2026-2-NCC6/Projeto1/README.md

# Swing Sense
Grupo 1 - 6º CCOMP
# FECAP - Fundação de Comércio Álvares Penteado
<p align="center">
<a href= "https://www.fecap.br/">FECAP - Fundação de Comércio Álvares Penteado</a>
</p>

# 👨‍💻 Integrantes:<a href="https://github.com/AntonioPetri">Antônio Petri de Moraes Soares de Moura e Oliveira</a>,<a href="https://github.com/paschoalha">Gabriel Higobassi Paschoal</a>, <a href="https://github.com/LucasSilvaMaciel">Lucas Silva Maciel</a>, <a href="https://github.com/ThiagoAkira0">Thiago Akira Higa Mitami</a>
# 👨‍🏫 Professores Orientadores: <a href="https://br.linkedin.com/in/edsonbarbero">Prof. Edson Ricardo Barbero,</a> <a href="https://www.linkedin.com/in/katia-bossi/">Prof. Katia Milani Lara Bossi,</a> <a href="https://www.linkedin.com/in/trencher/">Prof. João Francisco Trencher Martins,<a/> <a href="https://www.linkedin.com/in/professorrodnil/">Prof. Rodnil da Silva Moreira Lisboa <a/> e </a> <a href="https://www.linkedin.com/in/victorbarq/">Prof. Victor Bruno Alexander Rosetti de Quiroz </a>

# 📄 Descrição

O **Swing Sense** é uma raquete de tênis inteligente que capta os movimentos do jogador durante o jogo e identifica automaticamente o tipo de tacada executada — **saque, forehand ou backhand**. Um sensor de movimento (IMU) acoplado ao cabo da raquete, controlado por um microcontrolador ESP32, lê continuamente os dados de aceleração e rotação e os processa por meio de uma máquina de estados capaz de reconhecer o padrão de cada golpe.

Os dados são transmitidos via **Bluetooth (BLE)** para um aplicativo mobile, que exibe estatísticas de desempenho e histórico de treino ao jogador, sem que a raquete precise se conectar diretamente à internet.

O projeto integra, de forma prática, os conteúdos de cinco disciplinas do 6º semestre de Ciência da Computação:

- **Sistemas Embarcados e Robótica** — leitura de sensores e controle do microcontrolador;
- **Projeto Interdisciplinar (IoT)** — arquitetura do ecossistema raquete → app → backend;
- **Teoria da Computação e Linguagens Formais** — formalização da detecção de tacada como uma máquina de estados finitos;
- **Redes de Computadores e Cibersegurança** — comunicação segura entre dispositivo, aplicativo e servidor;
- **Inovação e Empreendedorismo** — estruturação da proposta como oportunidade de negócio.

# 📋 Detalhes
 🗂️ Estrutura de pastas<br>
 ├── 🗂️ Documentos/<br>
 │   ├── 📁 Entrega 1<br>
 │   │   └── 📂 Inovação e Empreendedorismo<br>
 │   │   └── 📂 Projeto Interdisciplinar: Internet das Coisas e Robótica<br>
 │   │   └── 📂 Teoria da Computação e Linguagens Formais<br>
 │   │   └── 📂 Redes de Computadores e Cibersegurança<br>
 │   │   └── 📂 Sistemas Embarcados e Robótica<br>
 │   ├── 📁 Entrega 2<br>
 │   │   └── 📂 Inovação e Empreendedorismo<br>
 │   │   └── 📂 Projeto Interdisciplinar: Internet das Coisas e Robótica<br>
 │   │   └── 📂 Teoria da Computação e Linguagens Formais<br>
 │   │   └── 📂 Redes de Computadores e Cibersegurança<br>
 │   │   └── 📂 Sistemas Embarcados e Robótica<br>
 │   ├── 📄 Banner_FECAP_CCOMP6_AGLT.pdf<br>
 │   ├── 📄 Banner_FECAP_CCOMP6_AGLT.pptx<br>
 │   └── 📄 Documento - Projeto de Extensão - COM Empresa<br>
 ├── 🗂️ Imagens/<br>
 ├── 🗂️ SRC/<br>
 ├── 📄 .gitignore<br>
 └── 📄 readme.md<br>
 
 # 💻 Tecnologias para Desenvolvimento

<ul>
  <li> <a href="https://code.visualstudio.com/">Visual Studio Code</a></li>
  <li> <a href="https://www.arduino.cc/">Arduino (ESP32)</a></li>
  <li> <a href="https://en.cppreference.com/">C/C++</a></li>
  <li> <a href="https://flutter.dev/">Flutter</a></li>
  <li> <a href="https://dart.dev/">Dart</a></li>
  <li> <a href="https://www.python.org/">Python</a></li>
  <li> <a href="https://fastapi.tiangolo.com/">FastAPI</a></li>
  <li> <a href="https://www.postgresql.org/">PostgreSQL</a></li>
  <li> <a href="https://github.com/">GitHub</a></li>
</ul>

# 📋 Licença/License
<a href="https://github.com/2026-2-NCC6/Projeto1">Swing Sense</a> © 2026 by <a href="https://github.com/2026-2-NCC6/Projeto1">Antônio Petri, Gabriel Paschoal, Lucas Maciel, Thiago Akira</a> is licensed under <a href="https://creativecommons.org/licenses/by/4.0/">CC BY 4.0</a>
