2026-2-NCC6/Projeto1/Documentos/Documento - Projeto de Extensao - COM EMPRESA.docx

DOCUMENTO DE PROJETO DE EXTENSÃO

1. DADOS GERAIS

Título do Projeto

Swing Sense: Sensor Embarcado Acoplável para Monitoramento de Desempenho.

Integrantes da equipe

Identificar o nome completo e o RA dos participantes do projeto

Nome: | RA:
Antônio Petri de Moraes Soares de Moura e Oliveira | 24026144
Gabriel Higobassi Paschoal | 21010656
Lucas Silva Maciel | 24025942
Thiago Akira Higa Mitami | 24026254

Professor responsável

Edson Ricardo Barbero, Katia Milani Lara Bossi, João Francisco Trencher Martins, Rodnil da Silva Moreira Lisboa e Victor Bruno Alexander Rosetti de Quiroz.

Curso

Ciência da Computação – 6° Semestre / 2026

Linha de atuação

Identificar com ✓ uma ou mais linhas de atuação conforme projeto pedagógico de curso.

- Projeto Interdisciplinar: | ✓

Tipo de projeto

Identificar com ✓ o tipo de projeto.

- Atividade de Extensão não implementado na prática (proposta de intervenção)
- Atividade de Extensão implementado na prática (intervenção executada) ✓

Tema gerador

ODS 3 – Saúde e Bem-Estar. Promoção da prática esportiva orientada por dados e acompanhamento da evolução física de praticantes amadores de tênis, por meio de sensoriamento embarcado de baixo custo.

Produto decorrente do projeto (opcional dependendo do tipo de projeto)

Protótipo de sensor IoT acoplável a raquetes de tênis (ESP32-C3 + IMU), integrado a aplicativo mobile para visualização de dados de força, velocidade e estilo de tacada. Evidências: simulação em Wokwi, fotos do protótipo físico montado e vídeo de demonstração de funcionamento.

2. IDENTIFICAÇÃO DO CENÁRIO DE INTERVENÇÃO E HIPÓTESES DE SOLUÇÃO

Local (cenário) previsto para a implementação do projeto

Quadras e espaços de prática de tênis amador na cidade de São Paulo, incluindo escolinhas, clubes e quadras de uso recreativo, onde o protótipo pode ser testado com jogadores em condições reais de jogo.

Público-alvo a ser atendido pelo projeto

Jogadores amadores de tênis, de diferentes faixas etárias e níveis técnicos, que praticam o esporte de forma recreativa ou buscam evoluir tecnicamente sem acompanhamento profissional constante. O levantamento inicial incluiu entrevista de campo com um jogador amador de 32 anos, que pratica duas vezes por semana, permitindo caracterizar hábitos de jogo, frustrações e expectativas desse público.

Apresentação do(s) problema(s) observado(s) e delimitação do objeto de estudo e intervenção

Jogadores amadores de tênis geralmente não têm acesso a nenhum tipo de análise técnica sobre suas próprias tacadas, dependendo de autoavaliação subjetiva ou da percepção de um treinador, nem sempre disponível. Soluções comerciais de sensoriamento esportivo já existiram (ex.: Babolat Play, Sony Smart Tennis Sensor, Zepp Tennis, HEAD Tennis Sensor), mas foram descontinuadas entre 2020 e 2021 por dependência de servidores proprietários, baixa precisão e aprisionamento a hardware específico — não por falta de interesse do público. Em entrevista de campo, identificou-se que o principal obstáculo do jogador amador não é a falta de interesse em acompanhar sua evolução, e sim o esforço e a complexidade exigidos pelas soluções hoje disponíveis, o que leva ao abandono do acompanhamento ao longo do tempo.

Definição de hipóteses para a solução do problema observado

Desenvolver um sensor de baixo custo, baseado em microcontrolador ESP32-C3 e unidade inercial (IMU), que possa ser acoplado a qualquer raquete de tênis já utilizada pelo jogador, sem exigir a troca de equipamento. Os dados de movimento captados durante o jogo (força do impacto, velocidade e estilo da tacada) são transmitidos via Bluetooth a um aplicativo mobile, que apresenta essas informações de forma simples e acessível, reduzindo a fricção de uso e incentivando a continuidade do acompanhamento esportivo pelo próprio jogador.

3 DESCRIÇÃO DO PROJETO

É importante destacar que um projeto de extensão não precisa ser necessariamente igual a um projeto de pesquisa. Mesmo que haja necessidade de pesquisa prévia para a fundamentação teórica, construção da introdução e para um melhor entendimento sobre a realidade a ser trabalhada, é preciso que um projeto de extensão contemple práticas que promovam mudanças e/ou melhorias identificadas como necessárias. O projeto final deverá ser simples, objetivo, claro e ter de 3 a 5 páginas, dentro do modelo aqui proposto.

Resumo

O projeto Swing Sense propõe o desenvolvimento de um protótipo de sensor embarcado, acoplável a raquetes de tênis, capaz de medir força, velocidade e estilo de tacada de jogadores amadores durante a prática esportiva. A proposta parte da constatação de que soluções comerciais de sensoriamento esportivo voltadas a esse público foram descontinuadas nos últimos anos, apesar da demanda existente, e de que o principal obstáculo para o acompanhamento técnico amador é a complexidade de uso, e não a falta de interesse. O público-alvo são jogadores amadores de tênis de diferentes níveis e faixas etárias. A metodologia combina pesquisa de campo, prototipagem eletrônica (ESP32-C3 e sensor inercial MPU6050) e desenvolvimento de aplicativo mobile conectado por Bluetooth. Como resultado esperado, pretende-se demonstrar a viabilidade técnica de um sistema de baixo custo e fácil adoção, capaz de aproximar a análise de desempenho esportivo da realidade do praticante amador, contribuindo para a promoção da prática esportiva e do bem-estar (ODS 3).

Introdução

A prática esportiva amadora tem papel reconhecido na promoção da saúde física e mental, estando diretamente relacionada ao Objetivo de Desenvolvimento Sustentável 3 (Saúde e Bem-Estar) da Agenda 2030 da ONU. No entanto, o acompanhamento técnico do desempenho esportivo — comum entre atletas profissionais — raramente está disponível para o praticante amador, que depende majoritariamente de autoavaliação ou de orientação eventual de um professor. O mercado já apresentou soluções de sensoriamento para raquetes de tênis voltadas a esse público (Babolat Play, Sony Smart Tennis Sensor, Zepp Tennis, HEAD Tennis Sensor), todas descontinuadas entre 2020 e 2021 em razão de dependência de servidores proprietários, baixa precisão de medição e aprisionamento tecnológico a hardware específico, e não por ausência de demanda. Esse cenário evidencia uma lacuna entre a necessidade latente do jogador amador por indicadores objetivos de evolução e a oferta atual de soluções acessíveis, simples e de baixo custo. O presente projeto de extensão propõe o desenvolvimento de um protótipo de sensor embarcado, de baixo custo e fácil instalação, capaz de medir força, velocidade e estilo de tacada diretamente na raquete do jogador, aproximando o acompanhamento técnico esportivo da realidade do praticante amador.

Objetivos

Desenvolver um protótipo de sensor embarcado (ESP32-C3 + IMU) acoplável a raquetes de tênis já utilizadas por jogadores amadores.

Captar, a partir dos dados do sensor, força, velocidade e estilo de tacada (forehand/backhand) executados durante o jogo.

Transmitir os dados captados via Bluetooth a um aplicativo mobile de fácil utilização pelo jogador amador.

Apresentar ao jogador indicadores simples e acessíveis de evolução técnica, reduzindo a fricção identificada como principal barreira de adoção desse tipo de solução.

Validar a viabilidade técnica do protótipo por meio de simulação e testes práticos do fluxo completo de captura e transmissão de dados.

Métodos

O projeto foi conduzido em etapas. Inicialmente, realizou-se levantamento diagnóstico junto ao público-alvo, por meio de entrevista de campo com um jogador amador, buscando identificar hábitos de jogo, frustrações e expectativas quanto ao acompanhamento de desempenho. A partir desse levantamento, foram definidos os requisitos do protótipo e sua arquitetura: um módulo eletrônico (ESP32-C3 e sensor inercial MPU6050) acoplado à ponta do cabo da raquete, que identifica o início e o fim de uma tacada por meio de uma máquina de estados (parado, preparação, impacto, recuperação), capturando força (pico de aceleração), velocidade e estilo de tacada no momento do impacto. Os dados são transmitidos via Bluetooth de baixa energia (BLE) a um aplicativo mobile, desenvolvido em Flutter, responsável por apresentar as informações ao jogador de forma simples e acessível. A simulação do circuito e dos testes de leitura de sensor foi realizada na ferramenta Wokwi, com medições elétricas básicas (tensão e corrente) para validação do funcionamento do protótipo.

Resultados (ou resultados esperados)

Espera-se demonstrar, de ponta a ponta, o funcionamento do protótipo: captura de dados de força, velocidade e estilo de tacada pelo sensor embarcado, transmissão via Bluetooth e exibição dessas informações em aplicativo mobile acessível ao jogador amador. Como impacto esperado, o projeto busca reduzir a barreira de complexidade hoje associada ao acompanhamento técnico esportivo, oferecendo ao praticante amador uma ferramenta de baixo custo que favoreça a continuidade e a evolução na prática do esporte, contribuindo para a promoção da saúde e do bem-estar (ODS 3) junto a esse público.

Considerações finais

O projeto Swing Sense buscou responder a uma lacuna identificada entre a demanda latente de jogadores amadores de tênis por acompanhamento técnico de seu desempenho e a ausência, hoje, de soluções acessíveis e de fácil adoção para esse fim. A proposta de um sensor embarcado de baixo custo, acoplável à raquete já utilizada pelo jogador, demonstrou-se tecnicamente viável nas etapas de prototipagem e simulação realizadas. Como direcionamento futuro, pretende-se validar o protótipo com um número maior de jogadores amadores em condições reais de jogo, calibrar com maior precisão a classificação de estilo de tacada e aprimorar a experiência do aplicativo mobile, de modo a ampliar o alcance e o impacto da intervenção proposta junto a esse público.

Referências

ORGANIZAÇÃO DAS NAÇÕES UNIDAS (ONU). Transformando Nosso Mundo: A Agenda 2030 para o Desenvolvimento Sustentável. Nova York: ONU, 2015.

CONFEDERAÇÃO BRASILEIRA DE TÊNIS (CBT). Dados sobre a prática de tênis no Brasil. Disponível em: https://cbt.com.br. Acesso em: 2026.

ANEXO I

As atividades de extensão podem resultar em produto caracterizado a partir do fazer extensionista, sempre mediados pela interação dialógica entre a comunidade acadêmica e a sociedade e seus setores, sendo exemplos: softwares; aplicativos; protótipos; desenhos técnicos; patentes; simuladores; objetos de aprendizagem; games; insumos alternativos; processos e procedimentos operativos inovadores; relatórios; relatos de experiências; cartilhas; revistas; manuais; jornais; informativos; livros; anais; cartazes; artigos; resumos; pôster; banner; site; portal; hotsite; fotografia; vídeos; áudios; tutoriais, dentre outros.

Fontes: | Links:

Documentos FECAP
Regulamento das Atividade de Extensão

Versão 3.0 – 05/2026
