2026-2-NCC6/Projeto1/Documentos/README.md

# Entregas do PI
### **DECLARAÇÃO DE USO DE INTELIGÊNCIA ARTIFICIAL**

## Entrega 1
<br><br>

### Disciplina 1 — Inovação e Empreendedorismo

| **Aluno(s) Responsável(veis)** | Antônio Petri, Gabriel Higobassi Paschoal, Lucas Silva Maciel, Thiago Akira Higa Mitami |
| :--- | :--- |
| **Ferramenta utilizada** | Claude (Anthropic) |
| **Versão/modelo** | Claude Sonnet 5, via claude.ai |
| **Disciplina / Trabalho** | Inovação e Empreendedorismo — Entrega 1 (análise da oportunidade) |
| **Finalidade de uso** | Apoio na organização e formatação do documento ABNT e dos slides a partir do conteúdo já definido pela equipe (persona, dores, TAM/SAM/SOM, análise de concorrência); revisão de clareza e estrutura textual. A análise empática (entrevista de campo), as premissas de mercado e os números de dimensionamento foram levantados e decididos pela equipe. |
| ***Prompts* principais utilizados** | "Formate esse conteúdo em um documento ABNT"; "Revise a clareza e a coerência deste texto sobre TAM/SAM/SOM"; "Ajude a estruturar os slides a partir desses dados" |
| **Trechos ou entregas afetadas** | Formatação do documento Word (ABNT) e do PowerPoint (18 slides); revisão textual. Conteúdo analítico, dados de mercado e premissas de autoria da equipe. |

### Disciplina 2 — Teoria da Computação e Linguagens Formais

| **Aluno(s) Responsável(veis)** | Antônio Petri, Gabriel Higobassi Paschoal, Lucas Silva Maciel, Thiago Akira Higa Mitami |
| :--- | :--- |
| **Ferramenta utilizada** | Claude (Anthropic) |
| **Versão/modelo** | Claude Sonnet 5, via claude.ai |
| **Disciplina / Trabalho** | Teoria da Computação e Linguagens Formais — Entrega 1 (modelagem formal) |
| **Finalidade de uso** | Apoio na formatação ABNT do documento e na revisão da consistência entre a máquina de estados já definida pela equipe (a partir do firmware real) e sua descrição formal (alfabeto, expressão regular, gramática). Auxílio na redação da introdução descrevendo o projeto. |
| ***Prompts* principais utilizados** | "Formate este documento em ABNT"; "Adicione um parágrafo na introdução explicando o que é o protótipo"; "Revise se a expressão regular e a gramática correspondem à máquina de estados" |
| **Trechos ou entregas afetadas** | Parágrafo introdutório (seção 1) e formatação geral do documento. Identificação dos estados, eventos, diagrama e tabela de transições foram definidos pela equipe a partir do firmware já implementado. |

### Disciplina 3 — Redes de Computadores e Cibersegurança

| **Aluno(s) Responsável(veis)** | Antônio Petri, Gabriel Higobassi Paschoal, Lucas Silva Maciel, Thiago Akira Higa Mitami |
| :--- | :--- |
| **Ferramenta utilizada** | Claude (Anthropic) |
| **Versão/modelo** | Claude Sonnet 5, via claude.ai |
| **Disciplina / Trabalho** | Redes de Computadores e Cibersegurança — Entrega 1 (relatório de vulnerabilidades) |
| **Finalidade de uso** | Apoio na organização e formatação do relatório de vulnerabilidades identificadas pela equipe, e sugestões de pontos a verificar (ex: segurança do pareamento BLE, armazenamento de credenciais) para validação dos testes feitos pelo grupo. |
| ***Prompts* principais utilizados** | "Ajude a organizar este relatório de vulnerabilidades em PDF/HTML"; "Quais categorias de risco de segurança costumam ser relevantes para comunicação BLE?" |
| **Trechos ou entregas afetadas** | Formatação e estruturação do relatório. Identificação e validação das vulnerabilidades específicas do sistema foram feitas pela equipe. |

### Disciplina 4 — Sistemas Embarcados e Robótica

| **Aluno(s) Responsável(veis)** | Antônio Petri, Gabriel Higobassi Paschoal, Lucas Silva Maciel, Thiago Akira Higa Mitami |
| :--- | :--- |
| **Ferramenta utilizada** | Claude (Anthropic) |
| **Versão/modelo** | Claude Sonnet 5, via claude.ai |
| **Disciplina / Trabalho** | Sistemas Embarcados e Robótica — Entrega 1 (montagem e testes de circuitos básicos) |
| **Finalidade de uso** | Revisão e conferência do relatório ABNT descrevendo os testes e medições (tensão, corrente) já realizados pela equipe na simulação Wokwi; checagem se o relatório atendia aos itens pedidos (esquema do circuito, testes, medições). |
| ***Prompts* principais utilizados** | "Confere se esse relatório atende ao que foi pedido na entrega"; "Revise a formatação ABNT deste relatório" |
| **Trechos ou entregas afetadas** | Revisão de formatação e conferência de completude do relatório. Montagem do circuito, testes e medições realizados pela equipe no Wokwi. |

### Disciplina 5 — Projeto Interdisciplinar: Internet das Coisas e Robótica

| **Aluno(s) Responsável(veis)** | Antônio Petri, Gabriel Higobassi Paschoal, Lucas Silva Maciel, Thiago Akira Higa Mitami |
| :--- | :--- |
| **Ferramenta utilizada** | Claude (Anthropic) |
| **Versão/modelo** | Claude Sonnet 5, via claude.ai |
| **Disciplina / Trabalho** | Projeto Interdisciplinar: IoT e Robótica — Entrega 1 (proposta técnica do sistema) |
| **Finalidade de uso** | Apoio na comparação entre versões do documento do PI (Smart Tennis Arena) para identificar mudanças de escopo e requisitos; apoio na organização do planejamento de arquitetura (raquete → app → backend) definido pela equipe; apoio na redação/formatação da documentação técnica. |
| ***Prompts* principais utilizados** | "Compare essa nova versão do PI com a anterior, mudou muito?"; "Ajude a organizar esse planejamento do ecossistema em um documento"; "Essa gamificação baseada em tempo de jogo atende aos requisitos do PI?" |
| **Trechos ou entregas afetadas** | Documento de planejamento da arquitetura e formatação da documentação técnica. Definição do escopo do protótipo, da arquitetura e das decisões de produto (ex: uso de força/velocidade/estilo de tacada na gamificação) foram feitas pela equipe. |

## Entrega 2
<br><br>

### Disciplina 1 — Inovação e Empreendedorismo

| **Aluno(s) Responsável(veis)** | Antônio Petri, Gabriel Higobassi Paschoal, Lucas Silva Maciel, Thiago Akira Higa Mitami |
| :--- | :--- |
| **Ferramenta utilizada** | Claude (Anthropic) |
| **Versão/modelo** | Claude Sonnet 5, via claude.ai |
| **Disciplina / Trabalho** | Inovação e Empreendedorismo — Entrega 2 (5 Forças de Porter + Business Model Canvas) |
| **Finalidade de uso** | Apoio na formatação ABNT do documento e dos slides a partir da análise estrutural do setor e do modelo de negócio já definidos pela equipe (decisão de que o comprador é o jogador amador adulto, e clubes/escolinhas/professores atuam como canal de indicação/parceria). Revisão de coerência entre os blocos do Canvas. |
| ***Prompts* principais utilizados** | "Formate esta análise de Porter e o Business Model Canvas em um documento ABNT"; "Revise se os blocos do Canvas estão coerentes entre si" |
| **Trechos ou entregas afetadas** | Formatação do documento e dos slides. Análise setorial, decisões estratégicas e estrutura do modelo de negócio de autoria da equipe. |

### Disciplina 2 — Teoria da Computação e Linguagens Formais

| **Aluno(s) Responsável(veis)** | Antônio Petri, Gabriel Higobassi Paschoal, Lucas Silva Maciel, Thiago Akira Higa Mitami |
| :--- | :--- |
| **Ferramenta utilizada** | Claude (Anthropic) |
| **Versão/modelo** | Claude Sonnet 5, via claude.ai |
| **Disciplina / Trabalho** | Teoria da Computação e Linguagens Formais — Entrega 2 (atualização formal das regras do sistema) |
| **Finalidade de uso** | Apoio na atualização da documentação formal após a equipe decidir remover a classificação de "saque" do MVP (mantendo apenas forehand/backhand) e revisão da justificativa de modelo computacional (autômato finito) escolhida pela equipe. |
| ***Prompts* principais utilizados** | "Atualize a máquina de estados removendo a classificação de saque"; "Revise se a justificativa do modelo computacional está coerente com as mudanças" |
| **Trechos ou entregas afetadas** | Atualização do diagrama e da tabela de transições, e da seção de justificativa. Decisão técnica de remover a classificação de saque tomada pela equipe após testes de campo. |

### Disciplina 3 — Redes de Computadores e Cibersegurança

| **Aluno(s) Responsável(veis)** | Antônio Petri, Gabriel Higobassi Paschoal, Lucas Silva Maciel, Thiago Akira Higa Mitami |
| :--- | :--- |
| **Ferramenta utilizada** | Claude (Anthropic) |
| **Versão/modelo** | Claude Sonnet 5, via claude.ai |
| **Disciplina / Trabalho** | Redes de Computadores e Cibersegurança — Entrega 2 (mitigação de vulnerabilidades) |
| **Finalidade de uso** | Apoio na organização do relatório complementar descrevendo as mitigações implementadas pela equipe no código do sistema. |
| ***Prompts* principais utilizados** | "Ajude a organizar o relatório complementar de mitigações"; "Revise a coerência entre os níveis dos riscos nas tabelas e nas matrizes" |
| **Trechos ou entregas afetadas** | Formatação do relatório complementar. Implementação das mitigações no código realizada pela equipe. |

### Disciplina 4 — Sistemas Embarcados e Robótica

| **Aluno(s) Responsável(veis)** | Antônio Petri, Gabriel Higobassi Paschoal, Lucas Silva Maciel, Thiago Akira Higa Mitami |
| :--- | :--- |
| **Ferramenta utilizada** | Claude (Anthropic) |
| **Versão/modelo** | Claude Sonnet 5, via claude.ai |
| **Disciplina / Trabalho** | Sistemas Embarcados e Robótica — Entrega 2 (programação e controle de dispositivos no Arduino) |
| **Finalidade de uso** | Apoio na revisão do código-fonte comentado e da descrição de funcionamento do firmware (leitura do MPU6050, controle de atuador) desenvolvidos pela equipe. |
| ***Prompts* principais utilizados** | "Revise os comentários deste código do firmware"; "Confere se a descrição do funcionamento está clara" |
| **Trechos ou entregas afetadas** | Revisão de comentários e clareza da descrição. Lógica de leitura de sensor e controle de atuador implementada pela equipe. |

### Disciplina 5 — Projeto Interdisciplinar: Internet das Coisas e Robótica

| **Aluno(s) Responsável(veis)** | Antônio Petri, Gabriel Higobassi Paschoal, Lucas Silva Maciel, Thiago Akira Higa Mitami |
| :--- | :--- |
| **Ferramenta utilizada** | Claude (Anthropic) |
| **Versão/modelo** | Claude Sonnet 5, via claude.ai |
| **Disciplina / Trabalho** | Projeto Interdisciplinar: IoT e Robótica — Entrega 2 (implementação final) |
| **Finalidade de uso** | Apoio na documentação da arquitetura final implementada (protótipo físico montado, app mobile conectado ao ESP32 via Bluetooth) e na organização da análise crítica de limitações, a partir das decisões e da integração feitas pela equipe. |
| ***Prompts* principais utilizados** | "Ajude a documentar a arquitetura final implementada"; "Organize a análise crítica das limitações do sistema" |
| **Trechos ou entregas afetadas** | Documentação da arquitetura final e formatação da análise crítica. Integração entre sensores, firmware e app, e as decisões técnicas, de autoria da equipe. |

***Declaro que o uso acima descrito está em conformidade com o GUIA PARA O USO RESPONSÁVEL DE
INTELIGÊNCIA ARTIFICIAL NA FECAP e que o conteúdo final é de minha plena responsabilidade
autoral.***
