2026-2-NCC6/Projeto1/Documentos/Entrega 1/Inovação e Empreendedorismo/Entrega 1 - Inovação e Empreendedorismo (2).pptx

PROJETO INTERDISCIPLINAR · 6º CCOMP · FECAP · 2026

Swing Sense

Sensor IoT para raquetes: da captura de movimento à análise de dados.

Inovação e Empreendedorismo — Entrega 1

Antônio Petri · Gabriel Higobassi Paschoal · Lucas Silva Maciel · Thiago Akira Higa Mitami

Notes: Abertura. O produto é um sensor acoplável à raquete. Hoje falamos da oportunidade, não da tecnologia.

## Slide 2

MÉTODO

Como chegamos ao problema

Design Thinking centrado no humano, estruturado em dois diamantes: divergir para entender, convergir para definir.

PROBLEMA

DESCOBRIR
DEFINIR

Entrevista em profundidade
revisão de concorrentes e literatura

SOLUÇÃO

IDEAR
PROTOTIPAR

Brainstorming · filtro pelo tripé
protótipo físico validado

Notes: A ideia não nasce de intuição tecnológica. Por isso começamos pelo método.

## Slide 3

DESCOBRIR

Fomos conversar com quem joga

ENTREVISTA EM PROFUNDIDADE

32 perguntas · ~30 minutos

Roteiro em 6 blocos: rotina de treino, percepção de evolução, tentativas anteriores de medir, comparação social, gasto mensal — e só no fim a reação à solução.

QUEM ENTREVISTAMOS

Rafael, 32 anos

Analista no setor financeiro · joga há 5 anos · 2x por semana · aula em grupo (4 alunos por professor) · gasta R$ 400–500/mês com o esporte. Entrevista realizada em 11/09/2026.

A frase que resume a entrevista

“Uma das coisas mais difíceis para quem joga por hobby é saber se realmente está evoluindo. Você joga toda semana, mas às vezes parece que está sempre no mesmo lugar.”

Notes: PREENCHER data e local antes de entregar. Se a entrevista ainda não foi feita de verdade, ela precisa ser feita: o edital pede evidência de aproximação real com o público.

## Slide 4

PERSONA

Rafael, 32 anos

Analista no financeiro · São Paulo · joga há 5 anos · 2x/semana · aula em grupo + jogo com amigos · R$ 400–500/mês

COMO ELE TREINA

- Uma aula em grupo na semana (4 alunos por professor) e um jogo com amigo no fim de semana.
- Começou porque um amigo do trabalho chamou. Ficou.
- Joga torneios internos de vez em quando; está nos grupos de WhatsApp do clube.
- Quando treina sozinho: “muitas vezes simplesmente jogo”.

O QUE JÁ TENTOU

- Gravou o saque com o celular a pedido do professor. Parou: “dá um pouco de trabalho”.
- Usa smartwatch na corrida e na academia. No tênis, nada.
- Comprou raquete mais cara achando que melhoraria o jogo — “o problema era mais técnico do que o equipamento”.

O QUE ELE DIZ QUE ESTÁ TRAVADO

“Meu saque. Estou praticamente no mesmo nível há mais de um ano.”

Ele sabe que evoluiu no geral — ganha de quem antes ganhava dele. Mas o saque não aparece no placar, e por isso escapa a qualquer avaliação.

O QUE ELE QUER SABER

“Velocidade do saque seria um. Também gostaria de saber quantos golpes eu dou e talvez quantos erros cometo. Às vezes tenho a sensação de que estou errando muito, mas não sei exatamente quanto.”

Notes: Persona construída a partir da entrevista, não de suposição. Todas as falas entre aspas são dele.

## Slide 5

EMPATIZAR

Mapa de empatia

Cada quadrante usa as palavras do próprio entrevistado.

PENSA E SENTE

“Seria interessante saber. Principalmente porque eu treino e queria ter alguma noção mais objetiva de que estou melhorando.”

VÊ

Na corrida: distância, tempo, ritmo, e o treino dos amigos. No tênis, o resultado do jogo — e nada além disso.

OUVE

Do professor: que chegou atrasado na bola e abriu demais o movimento. Do grupo do clube: quem está jogando bem.

FALA E FAZ

“Muitas vezes simplesmente jogo.” Gravou o saque uma vez e parou. Conta aos amigos quando ganha — nunca números.

DORES

Saque parado há mais de um ano. Não sabe quantos golpes deu nem quantos erros cometeu. Medir dá trabalho demais.

GANHOS

Um resumo simples depois do treino: quantos golpes, de que tipo, velocidade do saque — e comparação com os treinos anteriores.

Notes: Seis quadrantes, todos alimentados por respostas reais da entrevista.

## Slide 6

APRENDIZADO

O que a entrevista derrubou

Três hipóteses nossas não sobreviveram ao contato com o entrevistado. Registrá-las é parte do método.

O QUE ACHÁVAMOS

O QUE ELE DISSE

Ele não tem nenhuma noção de evolução

Ele tem — pelo placar. “Comecei a ganhar de algumas pessoas contra quem eu perdia.” O que falta é o dado técnico, não a percepção geral

A dor é aguda e urgente

“Um pouco. Não chega a ser algo que me incomode muito, mas seria interessante saber.” É latente, não urgente

Ele quer um ranking público do clube

“Se mostrasse que eu estou muito abaixo dos outros, provavelmente eu preferiria que não fosse público.” Comparação sim, exposição não

Consequência de projeto: a comunidade entra como comparação opcional e celebratória — não como placar público de fraqueza.

Notes: Este slide é o que demonstra maturidade analítica. Hipótese refutada é resultado, não erro.

## Slide 7

DEFINIR

O problema, precisamente definido

O praticante só enxerga o que o placar mostra — e o placar não mede técnica.

O QUE O PLACAR REVELA

Rafael sabe que evoluiu porque passou a ganhar de quem antes ganhava dele e mantém trocas de bola mais longas. É um sinal real, mas grosso: só aparece no agregado e leva meses.

O QUE ELE NÃO REVELA

O saque está parado há mais de um ano — e o saque não decide o placar sozinho. Golpes isolados, contagem de erros e velocidade não têm como emergir do resultado da partida.

E o único caminho hoje disponível — filmar e analisar — foi abandonado pelo motivo mais banal: “dá um pouco de trabalho”.

Notes: O problema não é ausência total de feedback: é ausência de feedback técnico, somada ao atrito de qualquer alternativa existente.

## Slide 8

A QUESTÃO NORTEADORA

Como podemos

mostrar ao praticante de tênis a evolução técnica que o placar não revela —

sem exigir dele nenhum esforço além de jogar?

As duas metades vêm da entrevista: o saque parado há um ano, e o “dá um pouco de trabalho” que fez ele largar o celular.

Notes: Slide-pivô. Ler em voz alta e pausar. A segunda metade da pergunta — o atrito zero — é o que diferencia de filmar.

## Slide 9

SOLUÇÃO

A resposta: Swing Sense

Módulo com ESP32-C3 e MPU6050 fixado no punho de qualquer raquete — o praticante prende e joga

1

Prende na raquete

Autômato de quatro estados identifica cada golpe pela aceleração e pelo giro, em tempo real

2

Detecta a tacada

Saque, forehand ou backhand — com a força e a velocidade de cada golpe, não apenas o total

3

Classifica e mede

Resumo simples ao fim do treino: golpes por tipo, velocidade do saque e comparação com as sessões anteriores

4

Mostra no app, sem trabalho nenhum

## Slide 10

OPORTUNIDADE

O mercado brasileiro de tênis

+2 mi

praticantes de tênis
no Brasil

CBT, 2023

3,0%

da população pratica
(era 2,6% em 2019)

ITF Global Tennis Report

+30%

crescimento dos esportes
de raquete desde 2022

CBT

R$ 400–500

gasto mensal declarado
pelo entrevistado

entrevista, 2026

Premissa conservadora adotada

Usamos 2,0 milhões de praticantes (CBT) e não os ~3 milhões de "adeptos" citados pela ÁPICE, porque o segundo número mistura praticantes e entusiastas.

Notes: O gasto mensal do quarto card veio da entrevista e confirma a premissa que tínhamos assumido.

## Slide 11

OPORTUNIDADE

TAM, SAM e SOM

Ticket adotado: R$ 299 por dispositivo. Testado na entrevista — “preço razoável se realmente funcionar bem”.

2.000.000 praticantes × R$ 299

TAM

R$ 598 mi

280.000 adultos, com renda, treinando ≥1x/semana

SAM

R$ 84 mi

9.240 unidades em 3 anos (0,3% → 2,0% do SAM)

Filtros do TAM ao SAM: adultos 18+ (70%) → renda compatível com acessório de R$ 299 (50%) → frequência mínima semanal (40%). Os três percentuais ainda são premissas da equipe e precisam de fonte secundária.

SOM

R$ 2,8 mi

Notes: O entrevistado validou o ticket, mas com ressalva: precisa confiar no dado antes de comprar. Isso vira requisito de acurácia.

## Slide 12

OPORTUNIDADE

E se as premissas estiverem erradas?

Testamos o SAM contra variações nas duas premissas mais frágeis — proporção de renda compatível e frequência de treino.

Leitura

- Mesmo no cenário pessimista, o mercado atingível passa de R$ 38 milhões.
- A operação é enxuta: o custo de material é de R$ 90–140 por unidade.
- A venda para escolinhas não está modelada — cada parceria vale ~10 unidades.
- Apresentar a faixa, e não um número único, é o que sustenta a estimativa sob questionamento.

Notes: Antecipa a pergunta da banca sobre a fragilidade das premissas.

## Slide 13

CONCORRÊNCIA

Este mercado já existiu — e ruiu

Entre 2020 e 2021, toda a primeira geração de sensores de raquete saiu do mercado em cerca de 18 meses.

Babolat Play

Vendas encerradas em mar/2021;
app desligado em 31/12/2021

Sony Smart
Tennis Sensor

Serviço encerrado
em 30/09/2021

Zepp Tennis

Servidor de autenticação
desligado; hardware inoperante

HEAD Tennis
Sensor

Descontinuado em 2021
(tecnologia Zepp)

Por que ruíram

Dependência de servidor proprietário

Acurácia insuficiente

Hardware preso a uma raquete

1

Quando a empresa desligou o backend, o hardware intacto na mão do cliente virou peso morto.

2

Zepp e Babolat entregavam só contagem total e velocidade média — nada por golpe individual.

3

O Babolat Play embutia o sensor no cabo: trocar de raquete significava perder o produto.

Notes: Não foi falta de demanda: foi arquitetura e modelo de negócio.

## Slide 14

DIFERENCIAÇÃO

O que a entrevista exige do produto

Cada requisito abaixo nasceu de uma fala do entrevistado — não de suposição da equipe.

O QUE ELE DISSE

REQUISITO QUE ISSO GERA

“Parei de filmar porque dá um pouco de trabalho”

Atrito zero: prender na raquete, jogar, ver o resumo. Nenhuma etapa manual

“Se tiver informação demais, pode ficar inútil. Não quero 30 gráficos”

Resumo simples na abertura: golpes por tipo, velocidade do saque, comparação com o treino anterior

“Pensaria se o sensor é preciso e se não atrapalha o movimento”

Acurácia medida e publicada; peso e equilíbrio como restrição de projeto do case

“Preferiria que não fosse público se estivesse abaixo dos outros”

Comparação opcional e por convite; nada exposto por padrão

Notes: Este slide liga a pesquisa ao produto. É o que prova que a entrevista mudou decisões reais.

## Slide 15

CONCORRÊNCIA

Como o Rafael resolve isso hoje

Preço em dólar, sem suporte no Brasil

DIRETO

Sensores importados remanescentes

4 alunos por professor · o feedback existe, mas é dividido

INDIRETO

Aula em grupo

Grátis — e abandonado: “dá um pouco de trabalho”

INDIRETO

Filmar com o celular

R$ 450 no último tênis · “o problema era mais técnico do que o equipamento”

SUBSTITUTO

Comprar equipamento melhor

R$ 0 — e é o concorrente mais forte de todos

Vender contra o não-consumo exige quebrar uma premissa antes de oferecer um produto: a de que tênis não se mede.

NÃO-CONSUMO

Simplesmente não medir nada

Notes: O concorrente principal não é a Sony nem a Zepp: é o hábito de não medir.

## Slide 16

PRÓXIMOS PASSOS

O que vem depois desta entrega

Mais 4 entrevistas, com praticantes de níveis diferentes — indicação do próprio entrevistado

1

Ampliar a amostra

Proporção de adultos entre praticantes e distribuição de renda, para firmar o SAM

2

Fechar as fontes das premissas

“Pensaria se o sensor é preciso” — medir contra vídeo e publicar o número

3

Validar acurácia do protótipo

Entrega 2 — 06/11

Notes: Fechar reconhecendo o que ainda falta. Uma entrevista é um começo, não uma amostra.

## Slide 17

REFERÊNCIAS

Fontes consultadas

Entrevista em profundidade com praticante amador de tênis, 32 anos. Realizada em 11 set. 2026. Dados primários.

CONFEDERAÇÃO BRASILEIRA DE TÊNIS. Dados de praticantes de tênis no Brasil, 2023. Via Tenis News.

ÁPICE BRASIL. Prática de tênis cresce no Brasil após a redução no imposto de importação das raquetes.

ITF. Global Tennis Report. Via Federação Paulista de Tênis.

ABIACOM. Esportes de raquete crescem no Brasil e movimentam as vendas online, 2025.

AURATIDE COLLECTIVE. Which Tennis Sensors Still Work in 2026.

SPORTS TECHNOLOGY BLOG. A Review of Smart Tennis Sensors, 2019.

FECAP. Projeto Interdisciplinar — Smart Tennis Arena, versão final, 6º CCOMP, 2026.

Notes: A entrevista aparece como fonte primária, em primeiro lugar. É o que o edital valoriza.

## Slide 18

OBRIGADO

Swing Sense

Medir o que o placar não mostra — sem exigir nada além de jogar.

Antônio Petri · Gabriel Higobassi Paschoal · Lucas Silva Maciel · Thiago Akira Higa Mitami

Inovação e Empreendedorismo · Projeto Interdisciplinar · 6º CCOMP · FECAP · 2026
