2026-2-NCC6/Projeto1/(commit log)

2026-09-01 Entrega 1 Sistemas Embarcados e Robotica
    Foi feito o prototipo fisicamente e pelo workwi para realizar um primeiro relatório de dados do prototipo
2026-09-01 Primeira Versão do circuito
    Feito o primeiro circuito para testar o microcontrolador e sensor para reconhecer os saques, forehand e backhand.
    Próximo passos é melhorar o reconhecimento e começar a conexão bluetooth
2026-09-01 Correção Entrega 1 Sistemas Embarcados e Robotica
    Acrescentado a explicação do que é o projeto e o que deve ver ao ser testado
2026-09-14 Aplicação do banco de dados(Supabase)
    Finalização do banco de dados em nuvem, eliminação do banco por memory store
2026-09-21 entrega 1 de redes
    entreg1. / redes
2026-10-20 Prototipo conectado com o APP
    Atualização para o app funcionar do android e conectar com o prototipo para mandar dados para a banco de dados.
2026-10-29 Estatisticas das tacadas da raquete real e consulta padronizada
    Banco (migration 002, aditiva, ja aplicada no Supabase):
    - sessoes_treinamento.is_demo e avg/max_racket_speed_kmh
    - triggers que mantem a velocidade da raquete da sessao e o
    dispositivos.last_sync_at a cada lote de tacadas
    - tipo 'SQ' (saque) aceito em tacadas
    - indice unico de dispositivo por usuario
    - views v_tacadas_sessao, v_tacadas_usuario e v_sessoes_qualidade
    (security_invoker, sem acesso pela chave publica)
    Backend:
    - POST /tacadas aceita SQ
    - GET /tacadas (paginado, filtro por sessao) e GET /tacadas/summary
    - sessao no JSON com avgRacketSpeedKmh, maxRacketSpeedKmh e isDemo
    - feed e perfil so listam sessoes com taca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
2026-11-08 Ficha de declaração de IA
2026-11-08 Atualização ficha de declaração IA
